CindyPotvin/WifiRelayESPHome/README.md

# Wifi Relay board to use with ESPHome

An ESP8266 board with a pair of relay for use with Home Assistant and ESPHome.

Parts list is in the parts.txt file.

Check out the following post for more details: https://robotsbench.com/controlling-relays-with-home-assistant-and-esphome/
