CindyPotvin/WifiRelayESPHome/parts.txt

C1 1uf
C2 1uf
FG18X7R1E105KRT00
https://www.mouser.ca/ProductDetail/810-FG18X7R1E105KRT0

J1 Terminal block relay VI0321550000G
J2 
https://www.mouser.ca/ProductDetail/CUI-Devices/TB002-500-03BE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

J3 Power
PJ-102AH 
https://www.mouser.ca/ProductDetail/CUI-Devices/PJ-102AH?qs=WyjlAZoYn50Yq4CrVLCXLw%3D%3D

R1 1k
R8 1k

R3 10k
R4 10k
R5 10k
R6 10k

R2 150
R9 150
R7 150

SW1 Switch to reset
B3F-1000 or B3F-1002
https://www.mouser.ca/ProductDetail/Omron-Electronics/B3F-1000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

SW2 Switch to program
EG1218 
https://www.mouser.ca/ProductDetail/E-Switch/EG1218?qs=sGAEpiMZZMtHXLepoqNyVZDOWY7elTCOE4MJ3sXRkSs%3D

U1 ESP8266 ESP-12F
https://www.ebay.ca/itm/ESP-12F-ESP8266-Remote-Serial-WIFI-Transceiver-Wireless-Adapter-Plate-Module/264051129457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

U2 Power regulator 3.3V
MCP1702-3302E/TO 
https://www.mouser.ca/ProductDetail/Microchip-Technology/MCP1702-3302E-TO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

J4 FTDI Cable socket
M20-9770346
https://www.mouser.ca/ProductDetail/Harwin/M20-9770346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

D1 1N4007
D2
https://www.mouser.ca/ProductDetail/583-1N4007-B

D2 LED LiteOn LTL2R3KGD-EM
D3 
D4
https://www.mouser.ca/ProductDetail/Lite-On/LTL2R3KGD-EM?qs=sGAEpiMZZMtmwHDZQCdlqY3QuPVQdrfivxVgVo2hFbg%3D

K1 Relay 1 Form C (SPDT-NO, NC) Coil voltage 3V, Switching max 250 VAC, 125 VDC, 10A
K2 Relay 1 Form C (SPDT-NO, NC) Coil voltage 3V, Switching max 250 VAC, 125 VDC, 10A
G5LE-14 DC3 https://www.mouser.ca/ProductDetail/Omron-Electronics/G5LE-14-DC3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

Q1 2N3904
Q2 
https://www.mouser.ca/ProductDetail/833-2N3904-AP
