CindyPotvin/WifiRelayESPHome/WifiRelayEspHome.kicad_pcb

## KiCad design WifiRelayEspHome.kicad_pcb (2023-04-10)

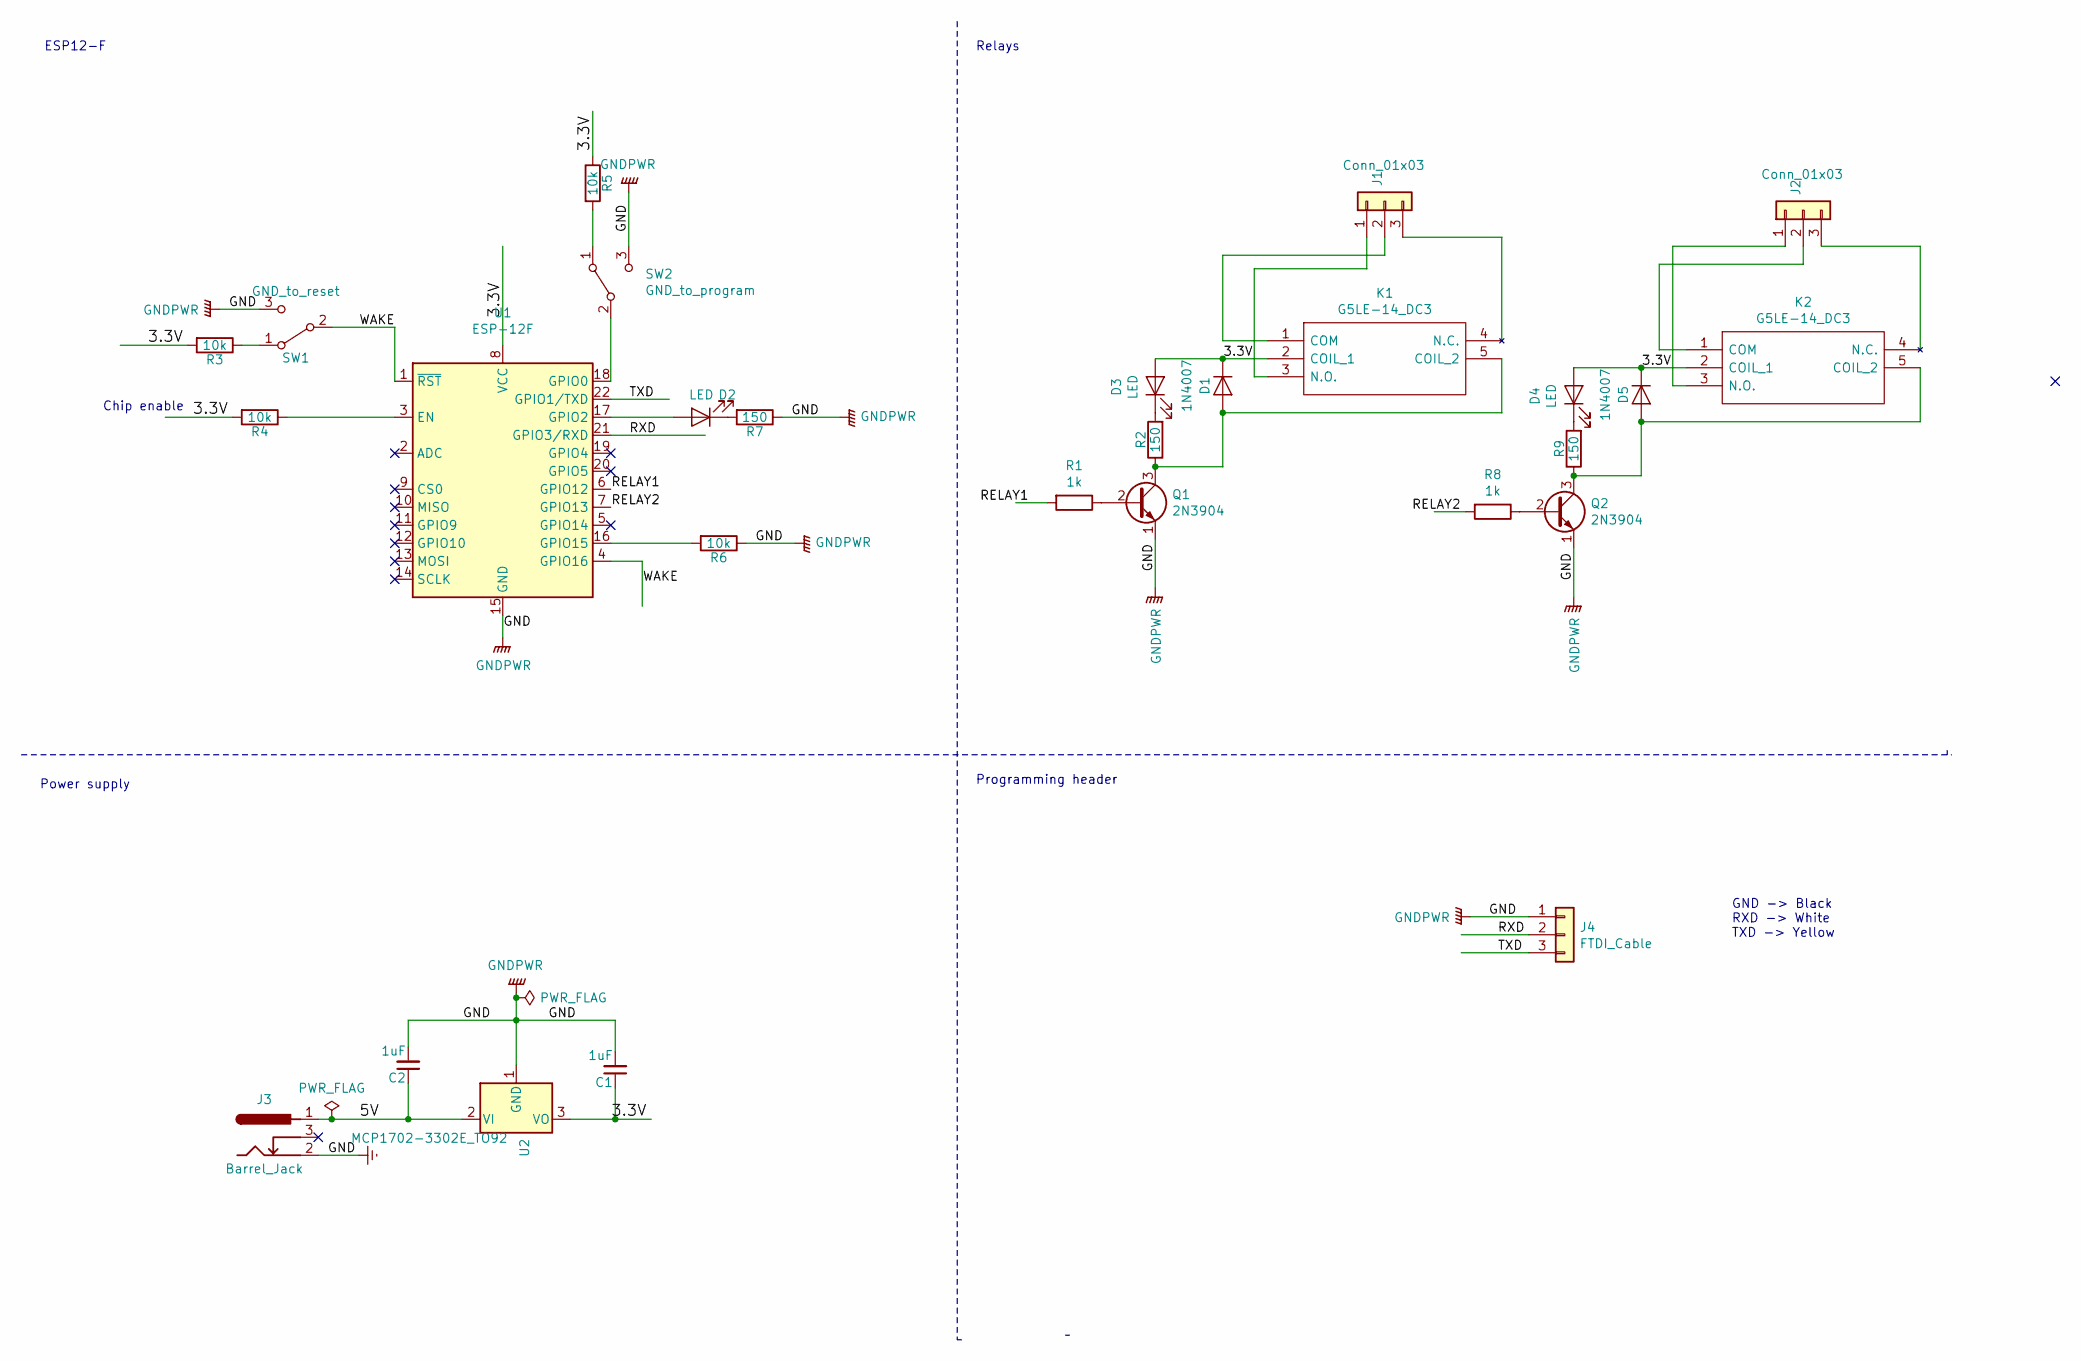
[picture p1: schematic WifiRelayEspHome.sch]

Parts:
C1, C2: 1uF; FG18X7R1H334KRT00
D1, D5: 1N4007; D_DO-35_SOD27_P7.62mm_Horizontal
D2, D3, D4: LED; LED_D5.0mm
J1, J2: Conn_01x03; SHDR3W100P0X500_1X3_1500X760X1000P
J3: Barrel_Jack; PJ-102AH
J4: FTDI_Cable; PinHeader_1x03_P2.54mm_Vertical
K1, K2: G5LE-14_DC3; G5LE-14_SPDT; Mouser Part Number 653-G5LE-14DC3
Q1, Q2: 2N3904; TO-92_Inline
R1, R8: 1k; R_Axial_DIN0207_L6.3mm_D2.5mm_P2.54mm_Vertical
R2, R7, R9: 150; R_Axial_DIN0204_L3.6mm_D1.6mm_P2.54mm_Vertical
R3, R4, R5, R6: 10k; R_Axial_DIN0207_L6.3mm_D2.5mm_P2.54mm_Vertical
SW1: GND_to_reset; B3F-1000
SW2: GND_to_program; EG1218
U1: ESP-12F; ESP-12E
U2: MCP1702-3302E_TO92; TO-92_Inline

Connections:
/3.3V: C1.1, D1.1 (K), D3.2 (A), D4.2 (A), D5.1 (K), K1.2 (COIL_1), K2.2 (COIL_1), R3.2, R4.2, R5.1, U1.8 (VCC), U2.3 (VO)
/5V: C2.1, J3.1, U2.2 (VI)
/RELAY1: R1.2, U1.6 (GPIO12)
/RELAY2: R8.2, U1.7 (GPIO13)
/RXD: J4.2, U1.21 (GPIO3/RXD)
/TXD: J4.3, U1.22 (GPIO1/TXD)
/WAKE: SW1.2 (B), U1.1 (~RST), U1.4 (GPIO16)
Earth: C1.2, C2.2, J3.2, J4.1, Q1.1 (E), Q2.1 (E), R6.1, R7.1, SW1.3 (C), SW2.3 (C), U1.15 (GND), U2.1 (GND)
unnamed: D1.2 (A), K1.5 (COIL_2), Q1.3 (C), R2.1
unnamed: D2.1 (K), R7.2
unnamed: D2.2 (A), U1.17 (GPIO2)
unnamed: D3.1 (K), R2.2
unnamed: D4.1 (K), R9.2
unnamed: D5.2 (A), K2.5 (COIL_2), Q2.3 (C), R9.1
unnamed: J1.1, K1.3 (N.O.)
unnamed: J1.2, K1.1 (COM)
unnamed: J1.3, K1.4 (N.C.)
unnamed: J2.1, K2.3 (N.O.)
unnamed: J2.2, K2.1 (COM)
unnamed: J2.3, K2.4 (N.C.)
unnamed: Q1.2 (B), R1.1
unnamed: Q2.2 (B), R8.1
unnamed: R3.1, SW1.1 (A)
unnamed: R4.1, U1.3 (EN)
unnamed: R5.2, SW2.1 (A)
unnamed: R6.2, U1.16 (GPIO15)
unnamed: SW2.2 (B), U1.18 (GPIO0)

Notes on the sheet:
Chip enable
GND -> Black RXD -> White TXD -> Yellow
ESP12-F
Power supply
Programming header
Relays

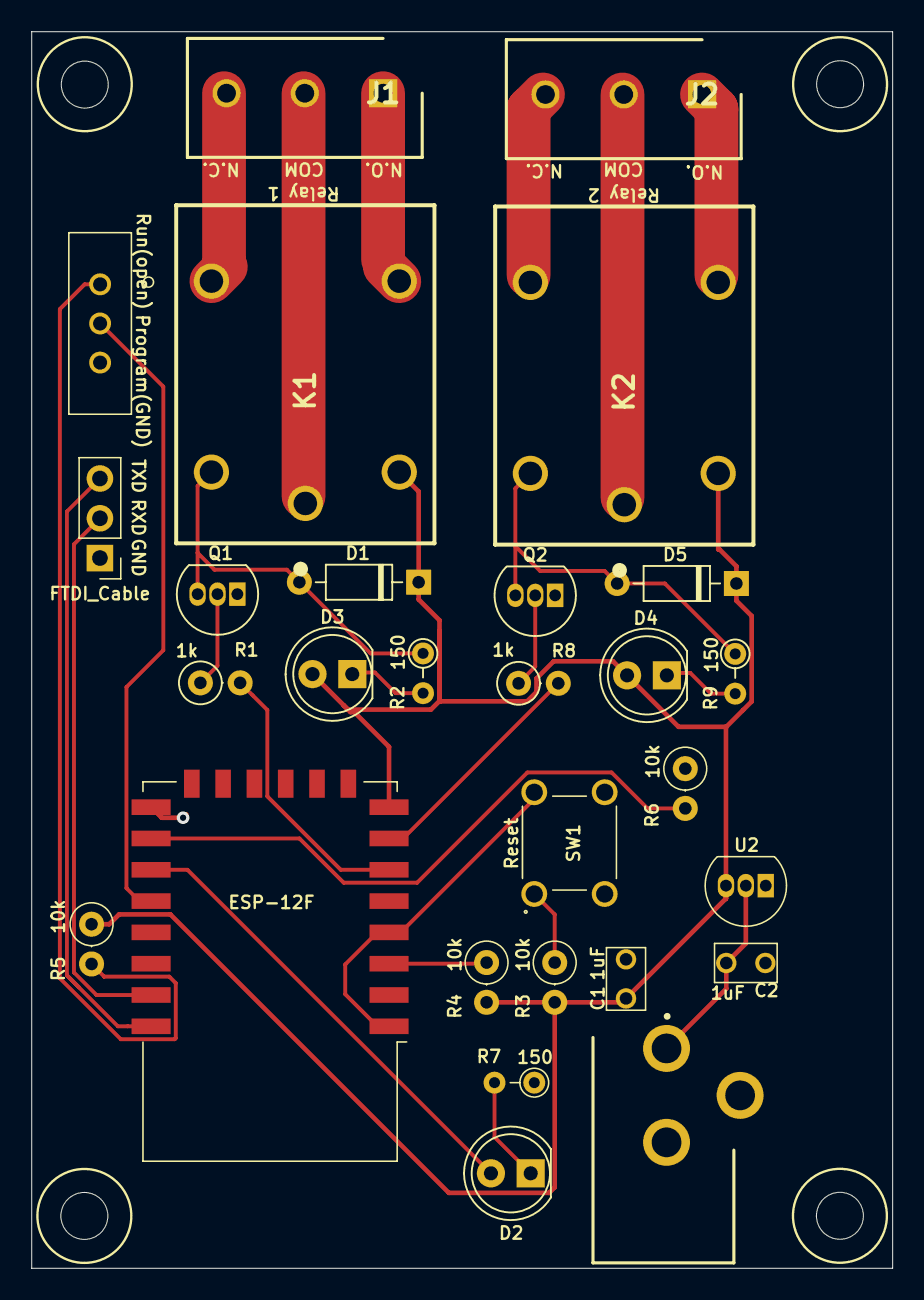
[picture p2: board WifiRelayEspHome.kicad_pcb from above]

Board: 2 copper layers, 55.0 x 79.0 mm, 28 parts (0 on the bottom side), 27 nets.
