CindyPotvin/WifiRelayESPHome/(commit log)

2022-03-06 First commit, before sending to fabrication
    [WifiRelayEspHome.kicad_pcb, WifiRelayEspHome.sch]
2022-03-07 Added github link to silkscren
    [WifiRelayEspHome.kicad_pcb]
2023-04-10 Final version after testing: changed pins, moved barrel jack and added mounting holes
    [WifiRelayEspHome.kicad_pcb, WifiRelayEspHome.sch]
